Carrigan/USBBusinessCard/bc_bom.xlsx

Manu. Part No. | Description | Price/Ea (qty 1) | Price/Ea (qty 10) | Qty | Notes
LPC1342FBD48,151 | USB Enabled Microcontroller | 4.09 | 3.65 | 1
AP7313-33SAG-7 | SOT23 3.3V Regulator | 0.46 | 0.36 | 1
GRPB052VWQS-RC | ARM Cortex M .05" Pitch Debug Header | 1.14 | 1.14 | 0 | Piece is removed after programming, does not add to price
DTA114YKAT146 | Pre-biased BJT Transistor for USB SoftConnect | 0.58 | 0.58 | 1
AT45DB081D-SSU | 8Mbit Serial Flash IC | 1.61 | 1.61 | 1
48037-0001 | USB Connector | 1.7 | 1.41 | 1
405C35E12M00000 | 12MHz 20pF Crystal | 1 | 0.88 | 1
APL3015SGC-F01 | Green LED | 0.18 | 0.135 | 1
APT3216SRCPRV | Red LED | 0.2 | 0.149 | 1
APT3216QBC/D | Blue LED | 0.41 | 0.311 | 1
 | 18pF 25V 0805 capacitor |  |  | 2
 | .1uF 0805 capacitor |  |  | 1
 | .1uF 1206 capacitor |  |  | 2 | 1206's used for the microcontroller (easier to get traces under them)
 | 1uF 0805 capacitor |  |  | 2
 | 33 Ohm Resistor |  |  | 2 | Voltage regulator calls these out
 | 10K 0805 resistor |  |  | 4
 | 1.5K 0805 resistor |  |  | 1
 | 1K 0805 resistor |  |  | 3 | Labeled as 330 Ohm in schematic, 1K gives a better brightness
Total Cost Each: |  | 10.23 | 9.085 |  | *Note - Resistors and capacitors not included.
