Carrigan/USBBusinessCard/Board/card.brd

## EAGLE design Board/card.brd (2013-08-16)

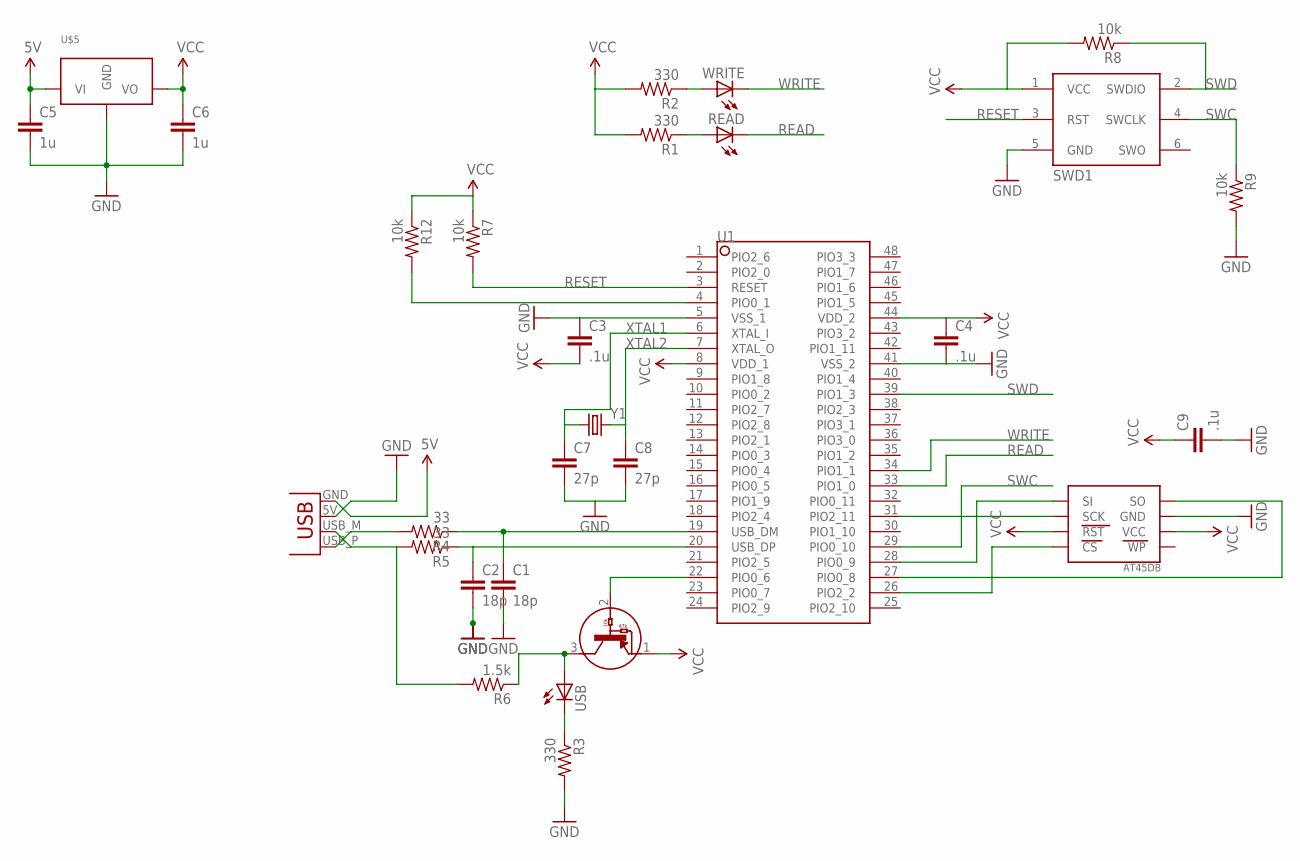
[picture p1: schematic card.sch]

Parts:
AT45DB: AT45DBXXXD; SOIC8
C1, C2: 18p; 0805
C3, C4: .1u; 1206
C5, C6: 1u; 0805
C7, C8: 27p; 0805
C9: .1u; 0805
JP1: USBPCB; USB-A-PCB
R1, R2, R3: 330; 0805
R4, R5: 33; 0805
R6: 1.5k; 0805
R7, R8, R9, R12: 10k; 0805
READ: LED1206; LED-1206
SWD1: TC2030CTX_NL; TC2030-NL
U1: LPC1343FBD48; LQFP48
U3: DTA114YKA
U$5: 3_3V_REG; SOT23
USB: LED1206; LED-1206
WRITE: LED1206; LED-1206
Y1: CRYSTAL5X3; CRYSTAL-SMD-5X3

Connections:
5V: C5.1, JP1.GND, U$5.1 (VI)
GND: AT45DB.7 (GND), C1.2, C2.2, C3.1, C4.2, C5.2, C6.2, C7.2, C8.2, C9.2, JP1.5V (VBUS), R3.2, R9.2, SWD1.5 (GND), U1.5 (VSS_1), U1.41 (VSS_2), U$5.3 (GND)
unnamed: C1.1, R4.1, U1.19 (USB_DM)
unnamed: JP1.USB_M (D-), R5.2, R6.2
unnamed: C2.1, R5.1, U1.20 (USB_DP)
unnamed: AT45DB.2 (SCK), U1.31 (PIO2_11)
unnamed: R1.1, READ.A
unnamed: AT45DB.8 (SO), U1.27 (PIO0_8)
unnamed: R2.1, WRITE.A
unnamed: R6.1, U3.3, USB.A
unnamed: R3.1, USB.C
unnamed: U1.22 (PIO0_6), U3.2
unnamed: AT45DB.4 (CS), U1.26 (PIO2_2)
unnamed: R12.2, U1.4 (PIO0_1)
unnamed: JP1.USB_P (D+), R4.2
READ: READ.C, U1.33 (PIO1_0)
RESET: R7.2, SWD1.3 (RST), U1.3 (RESET)
SWC: R9.1, SWD1.4 (SWCLK), U1.29 (PIO0_10)
SWD: R8.1, SWD1.2 (SWDIO), U1.39 (PIO1_3)
SWV: AT45DB.1 (SI), U1.28 (PIO0_9)
VCC: AT45DB.3 (RST), AT45DB.6 (VCC), C3.2, C4.1, C6.1, C9.1, R1.2, R2.2, R7.1, R8.2, R12.1, SWD1.1 (VCC), U1.8 (VDD_1), U1.44 (VDD_2), U3.1, U$5.2 (VO)
WRITE: U1.34 (PIO1_1), WRITE.C
XTAL1: C7.1, U1.6 (XTAL_I), Y1.1
XTAL2: C8.1, U1.7 (XTAL_O), Y1.3 (2)

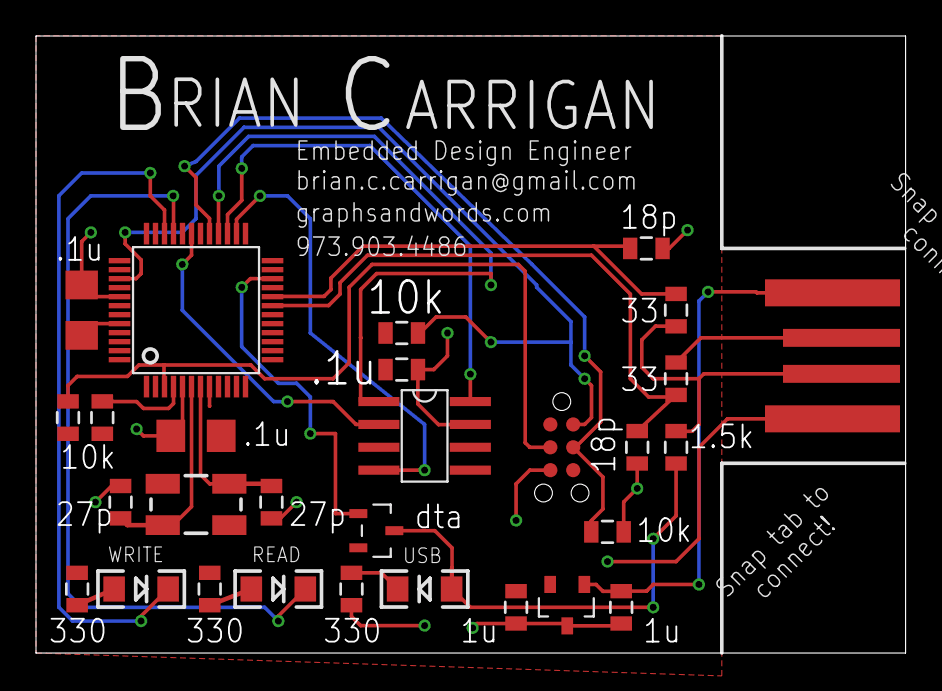
[picture p2: board card.brd from above]

Board: 2 copper layers, 48.3 x 34.3 mm, 29 parts (0 on the bottom side), 24 nets.
