Carrigan/USBBusinessCard/Source/at45db.c

/**
  	@author Brian Carrigan
  	@date 7/12/2012
	@file at45db.c
  	Email brian.c.carrigan@gmail.com
 
	This file is part of the AT45DB LPC-Library.

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
    You should have received a copy of the GNU General Public License
    along with the AT45DB LPC-Library.  If not, 
    see <http://www.gnu.org/licenses/>.
 */

#include "spi.h"
#include "at45db.h"


#define MAIN_PAGE_READ		0x03	///<	Command ID of the Main Page Read operation
#define MAIN_PAGE_BUF1WRITE	0x82	///<	Command ID of the Buffer 1 Write operation
#define MAIN_PAGE_TO_BUF1	0x53	///<	Command ID of the Main Page -> Buffer 1 operation
#define MAIN_PAGE_BUF1_COMP	0x60	///<	Command ID of the Buffer 1 Compare operation
#define READ_STATE_REGISTER 0xD7	///<	Command ID of the Read State Register operation


/**
 *	@brief Blocking function that waits for the AT45DB to finish it's current 
 *
 */
static void AT45DB_WaitForBusy()
{
	unsigned char isBusy = 0;
	SPI_CS_ENABLE();
	SPI_ReadWrite(READ_STATE_REGISTER);
	do
	{
		isBusy = SPI_ReadWrite(SPI_DUMMY);
	} while(!(isBusy & 0x80));
	SPI_CS_DISABLE();	
}

/**
 *	@brief Writes an array of data to the AT45DB081, starting at a specific offset.
 *
 *	@param *array A pointer to the array of data to be sent.
 *	@param length Length of data to be written.
 *	@param offset Position (byte number) to be written to on the AT45DB.
 */
void AT45DB_ReadIntoArray(unsigned char *array, unsigned int length, unsigned int offset)
{
	unsigned short 	page_offset;
	unsigned short 	byte_offset;
	
	// If the offset is not valid:
	if(offset > AT45DB_TOTALMEM)
		return;

	// Wait for the AT45 to finish it's current duties.
	AT45DB_WaitForBusy();

	// Assert the CS line and tell the AT45DB
	SPI_CS_ENABLE();
	SPI_ReadWrite(MAIN_PAGE_READ);
	
	// Compute the offset.
	page_offset = offset / AT45DB_BLOCKSIZE;
	byte_offset = offset % AT45DB_BLOCKSIZE;

	// Write the offset
	SPI_ReadWrite(page_offset >> 7);
	SPI_ReadWrite(((page_offset & 0x7F)<<1) + (byte_offset >> 8));
	SPI_ReadWrite(byte_offset & 0xFF);

	// Continue reading until done
	while(length > 0)
	{
		*array = SPI_ReadWrite(SPI_DUMMY);
		array++;
		length--;
	}

	// Deassert SPI
	SPI_CS_DISABLE();
}


/**
 *	@brief Reads an array of data from the AT45DB081, starting at a specific offset.
 *
 *	@param *array A pointer to the array where incoming data will be written to.
 *	@param length Length of data to be read.
 *	@param offset Position (byte number) of data to be read from the AT45DB.
 */
void AT45DB_WriteFromArray(unsigned char *array, unsigned int length, unsigned int offset)
{
	unsigned short 	page_offset;
	unsigned short 	byte_offset;
	unsigned char 	mathbyte;
	
	// If the offset is not valid:
	if(offset > AT45DB_TOTALMEM)
		return;

	// Compute the offset
	page_offset = offset / AT45DB_BLOCKSIZE;
	byte_offset = offset % AT45DB_BLOCKSIZE;

	// For each page, do this operation
	do
	{
		// Wait for the flash to be ready.
		AT45DB_WaitForBusy();
		
		// Load the page into SRAM
		SPI_CS_ENABLE();
		SPI_ReadWrite(MAIN_PAGE_TO_BUF1);
		SPI_ReadWrite(page_offset >> 7);
		mathbyte = (page_offset & 0x7F)<<1;
		SPI_ReadWrite(mathbyte);
		SPI_ReadWrite(SPI_DUMMY);
		SPI_CS_DISABLE();
		
		// Wait for the page to be in RAM
		AT45DB_WaitForBusy();
	
		// Write the data
		SPI_CS_ENABLE();
		SPI_ReadWrite(MAIN_PAGE_BUF1WRITE);
		SPI_ReadWrite(page_offset >> 7);
		mathbyte = ((page_offset & 0x7F)<<1) + (byte_offset >> 8);
		SPI_ReadWrite(mathbyte);
		SPI_ReadWrite(byte_offset & 0xFF);
		do
		{
			SPI_ReadWrite(*array);
			array++;
			length--;
			byte_offset++;
		} while (byte_offset < AT45DB_BLOCKSIZE && length > 0); 		 
		SPI_CS_DISABLE();
		
		// Is the operation complete?
		if(length > 0)
		{
			byte_offset = 0;
			page_offset++;	
		} else {
			break;
		}	
	} while (1);
}
