Carrigan/USBBusinessCard/(commit log)

2013-03-06 Fixed a few math errors and improved write speeds.
    [at45db.c, at45db.h, bc.c, memory.c, mscuser.h]
2013-08-16 Added Eagle files.
    [card.brd, card.sch]
2017-05-29 Add in the BOM here.
    [bc_bom.xlsx]
