Carrigan/USBBusinessCard/(notices)

Notices in the files:
Source/at45db.c:
General Public License as published by the Free Software Foundation,
either version 3 of the License, or (at your option) any later
parts and their libraries:
SparkFun-Connectors: Licensing: CC v3.0 Share-Alike You are welcome to use this library for commercial purposes.
